cslammy/tubetrashexperimenterboard/README.md

# tubetrashexperimenterboard
1J24B board used to help design waveform modifiers, vcfs etc
see more information in this blog post: https://audiodiwhy.blogspot.com/2022/02/1j24b-part-ii-expermenters-board.html
