cslammy/tubetrashexperimenterboard/tube timbre trasher 1-9-22 notes.pdf

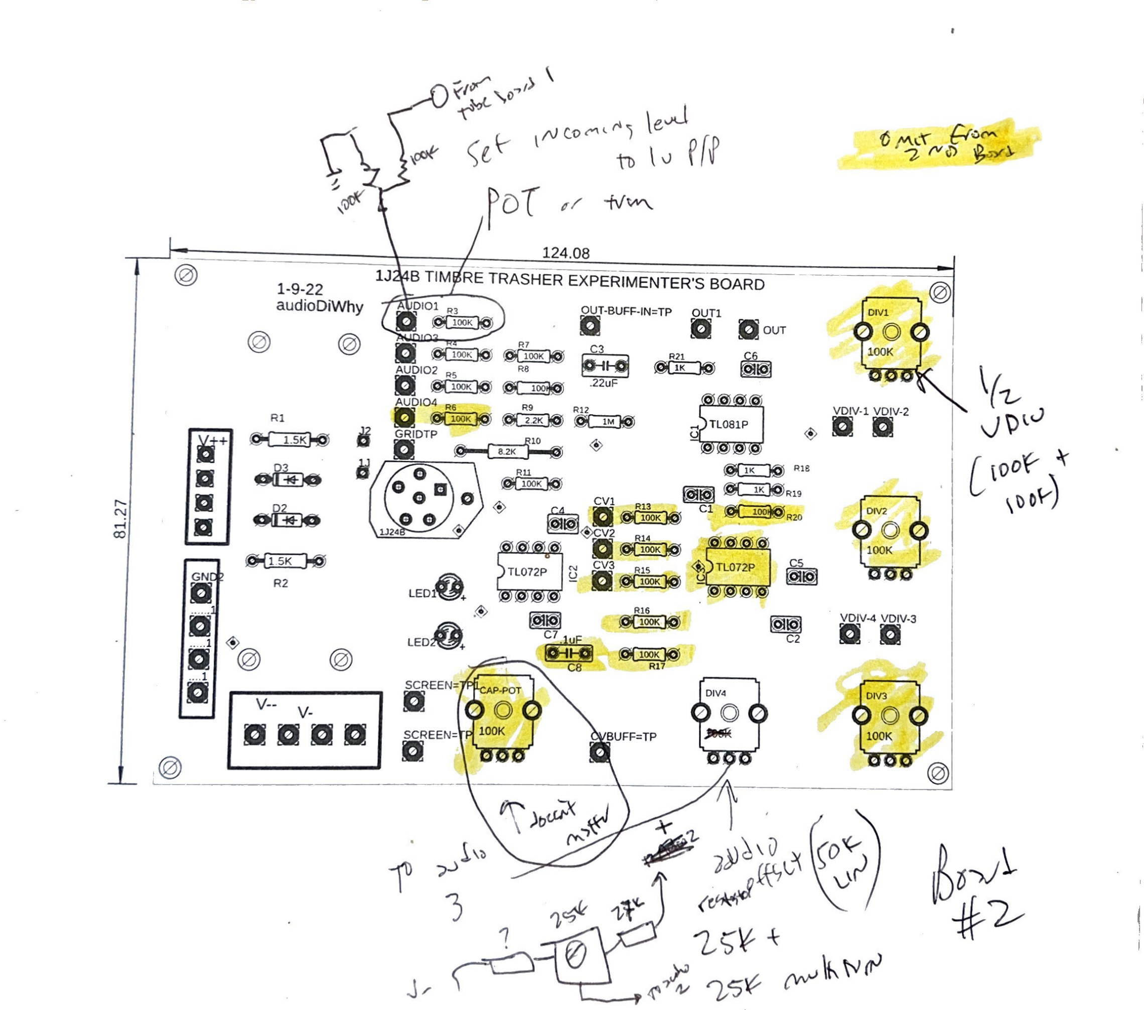
[picture p1: page 1]

ov | Evo | ®
ZOO Bor?

1-9-22
audioDiwhy | QUT-BUFF-INSTP | QUT1

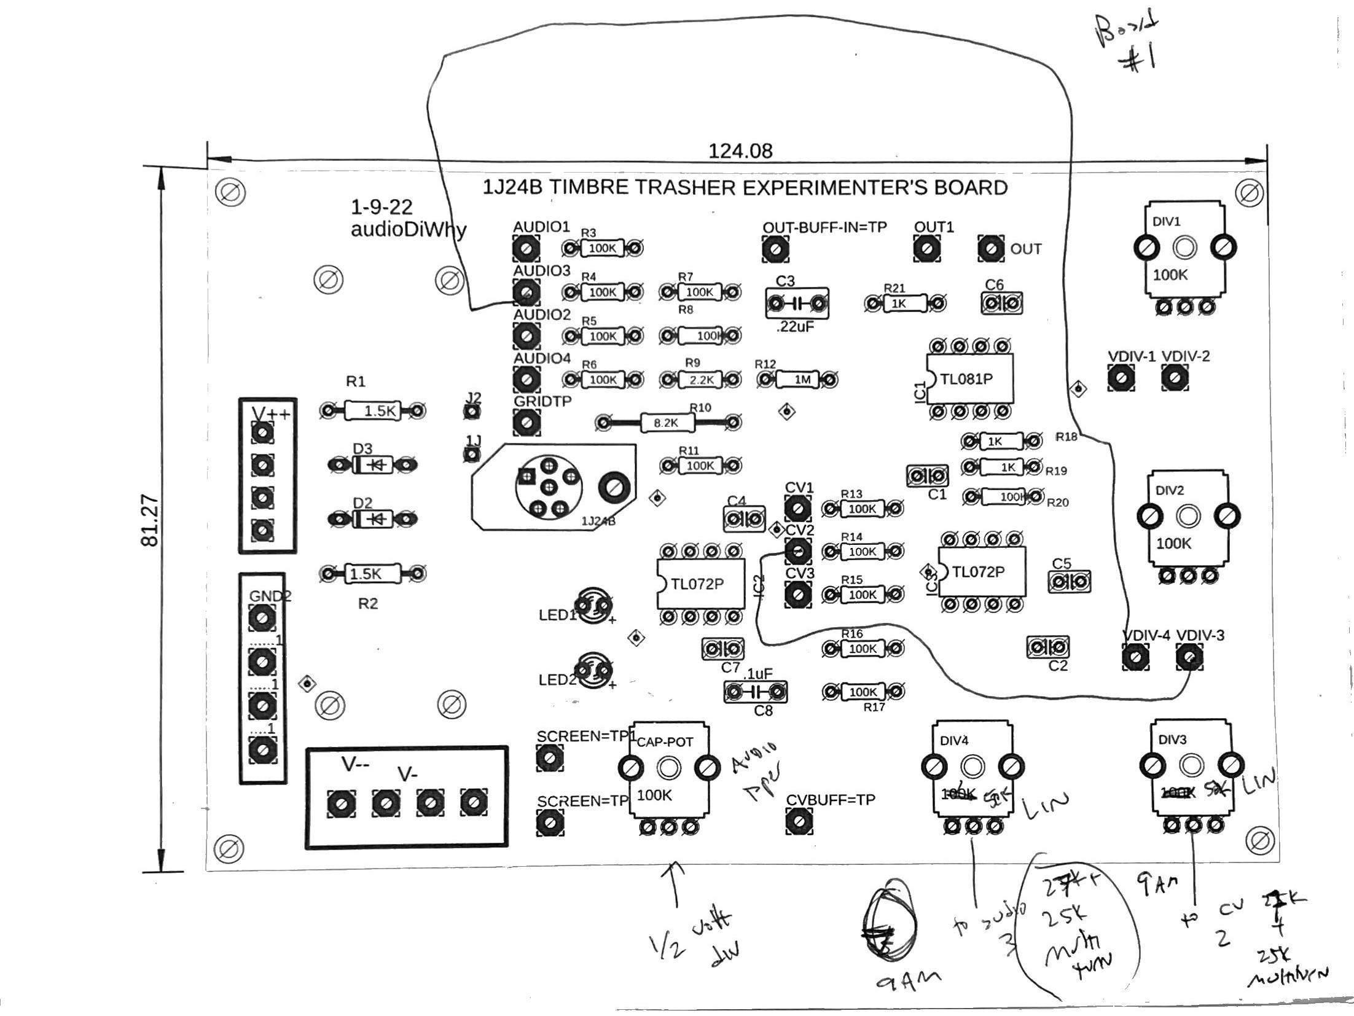
[picture p2: page 2]

~ 1924BTIMBRE TRASHER EXPERIMENTER'S BOARD _

audioDiwhy | AUDIOL ps | QUT-BUFF-IN=TP | OUT

124.08

Lic} | Oo | QO | Qo

a

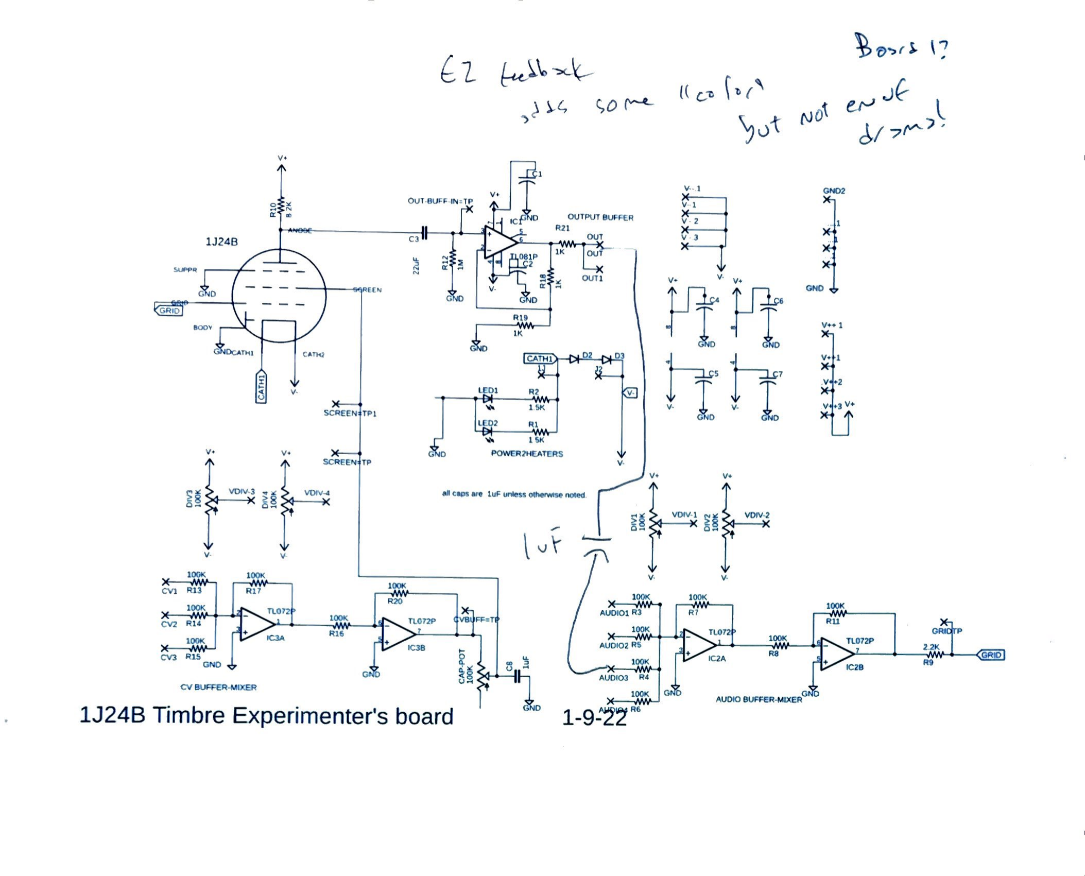
[picture p3: page 3]

B
é

1J24B Timbre Experimenter's board

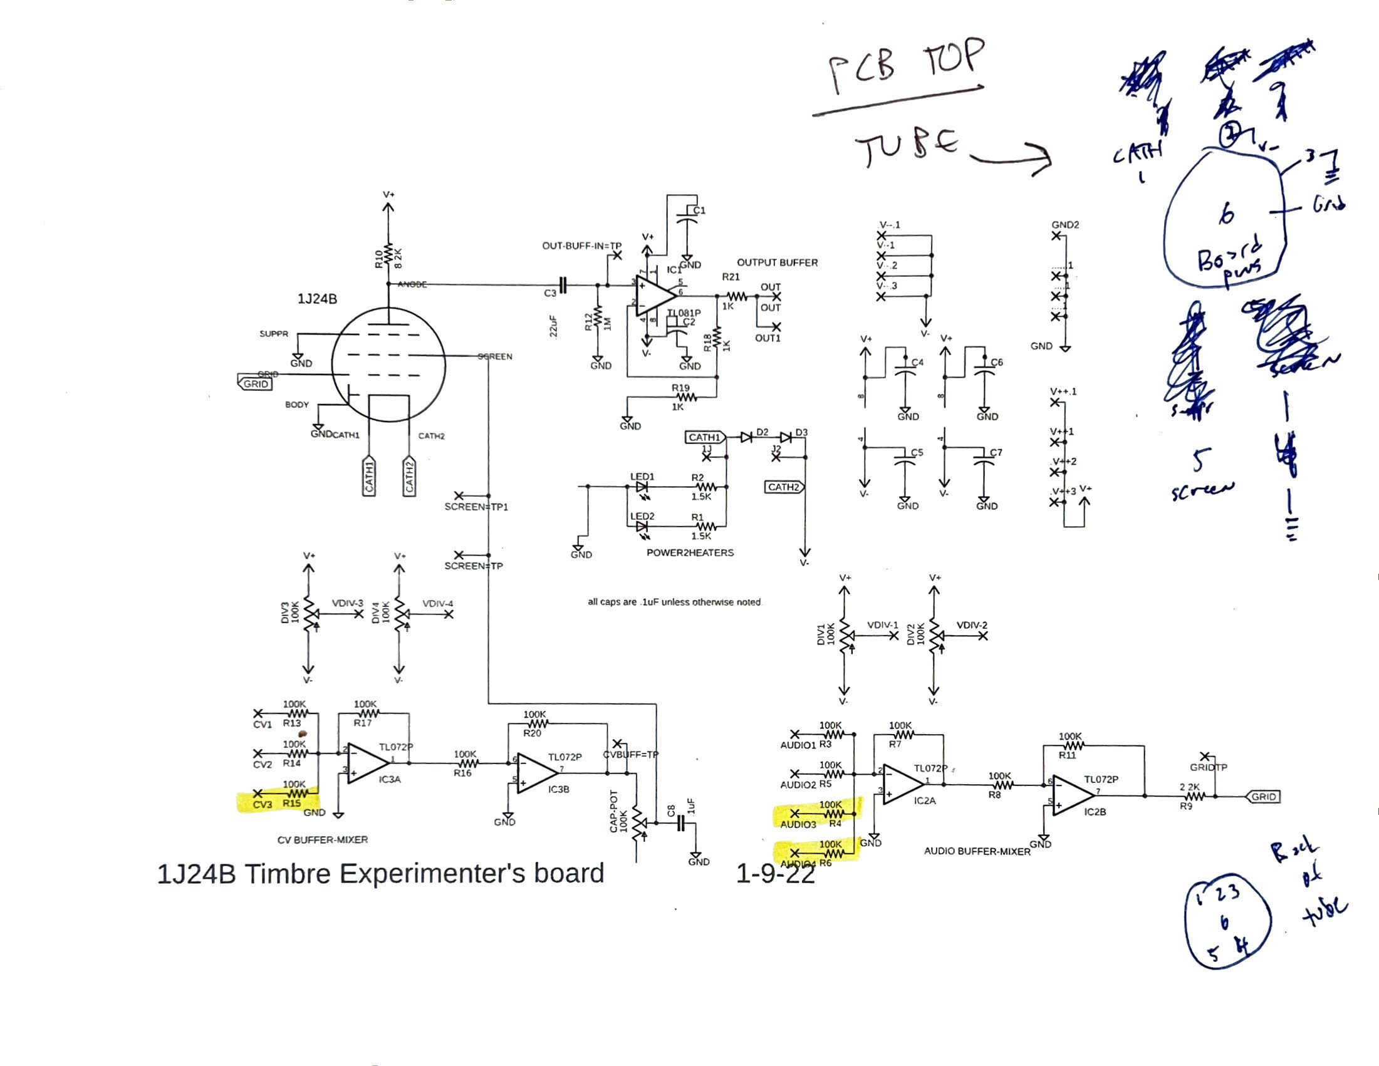
[picture p4: page 4]

all capsare .luFunless otherwise noled

iD
1J24B Timbre Experimenter's board
