cslammy/tubetrashexperimenterboard/tubetimbertrasher pcb and schem.pdf

3

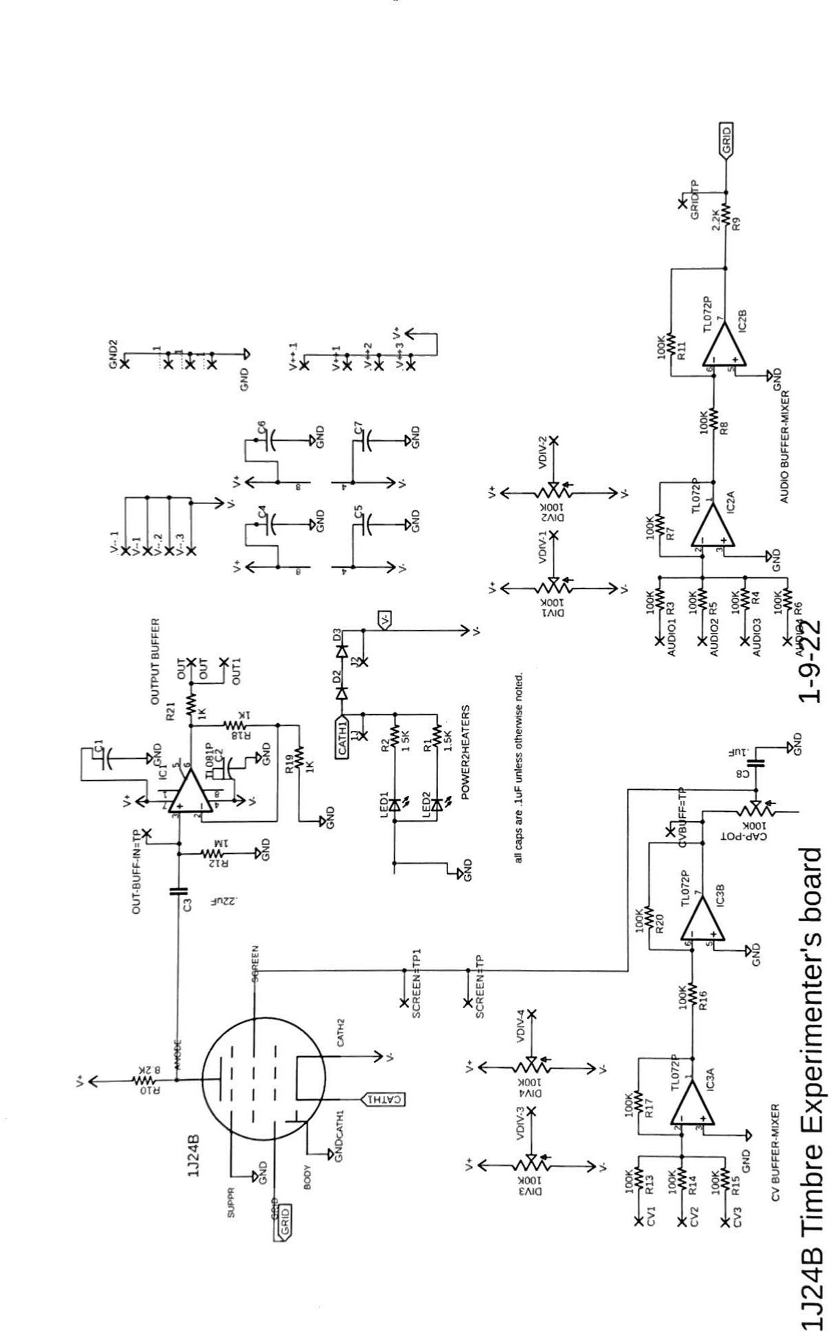
[picture p5: page 1]

"paiou aswmuaipo ssapun nT" are sete ye

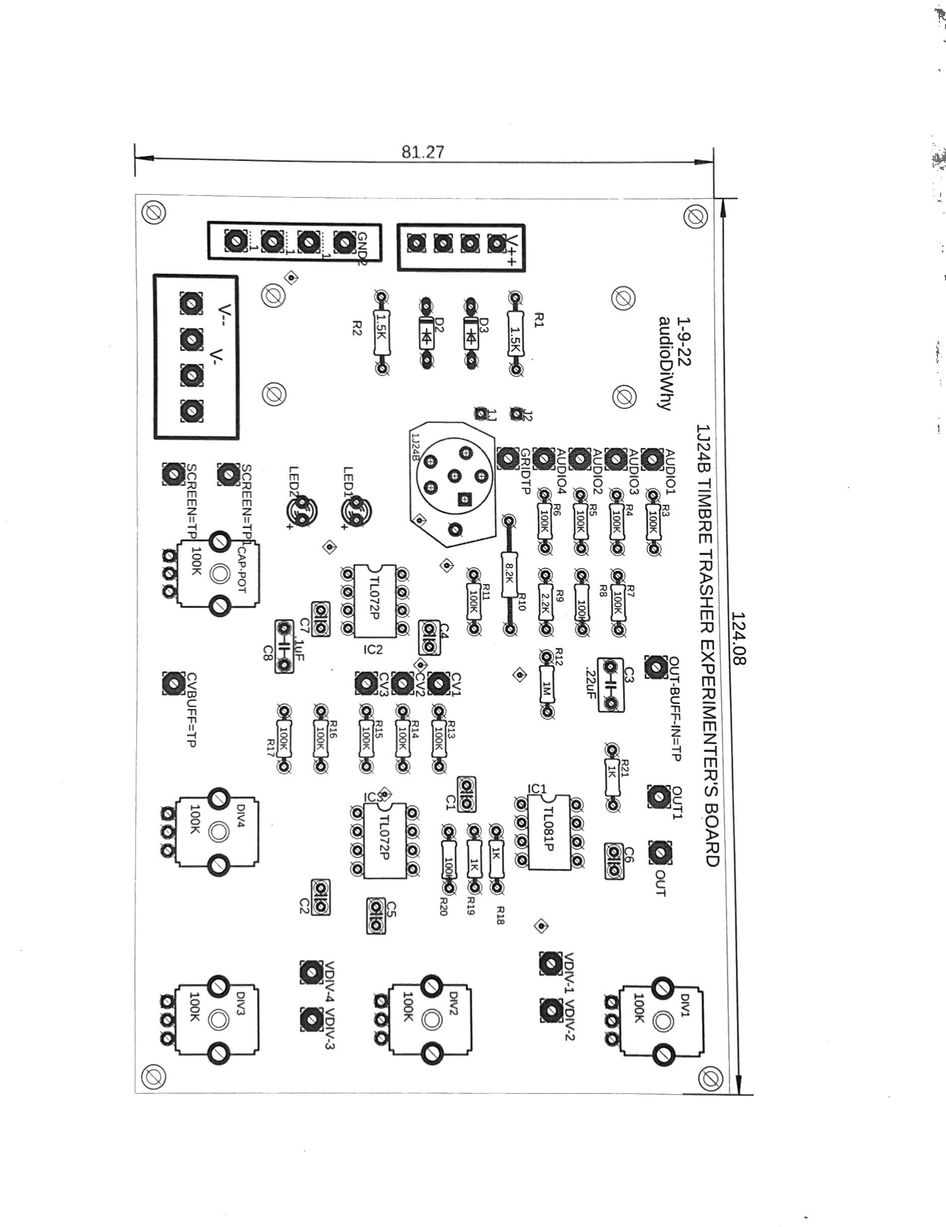
[picture p6: page 2]

©

1.9.29 1J24B TIMBRE TRASHR EXPERIMENTER'S BOARD

audioDiwhy QUT-BUFFAN=TP

=

# OUT]

# SoGOBu

©

# AUDIO2 ps

car

## OspeAUDIO4

CVBUFF=TP
