cslammy/tubetrashexperimenterboard/board.PNG

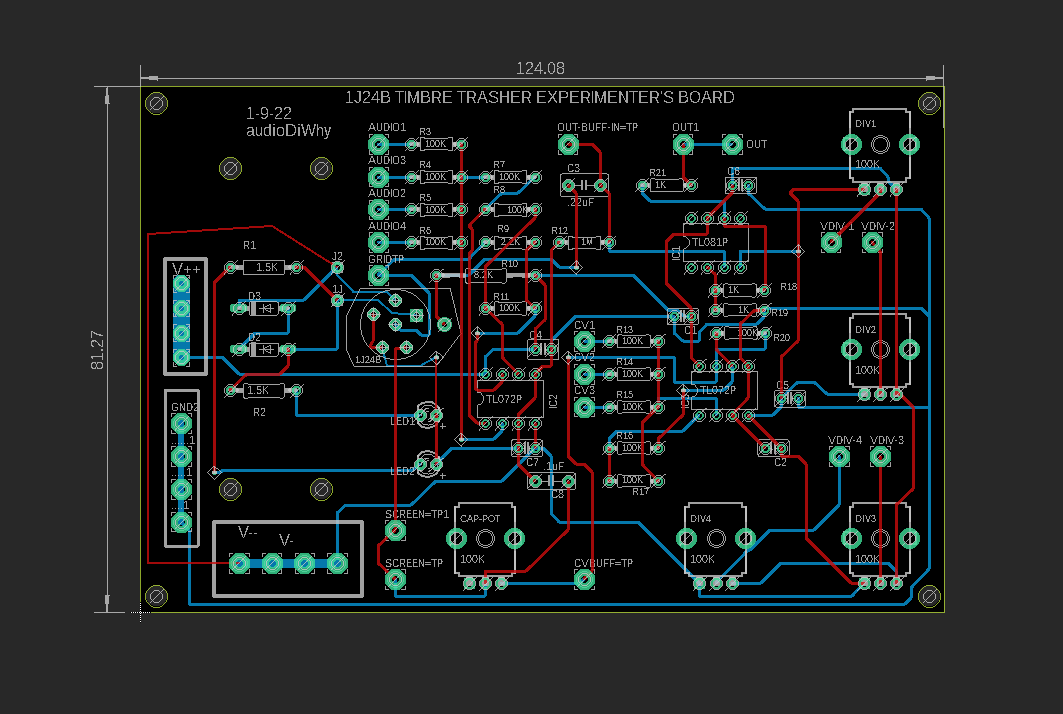
board.PNG
