cslammy/tubetrashexperimenterboard/tube timbre trasher 1-9-22-fix.brd

## EAGLE design tube timbre trasher 1-9-22-fix.brd (2022-02-13)

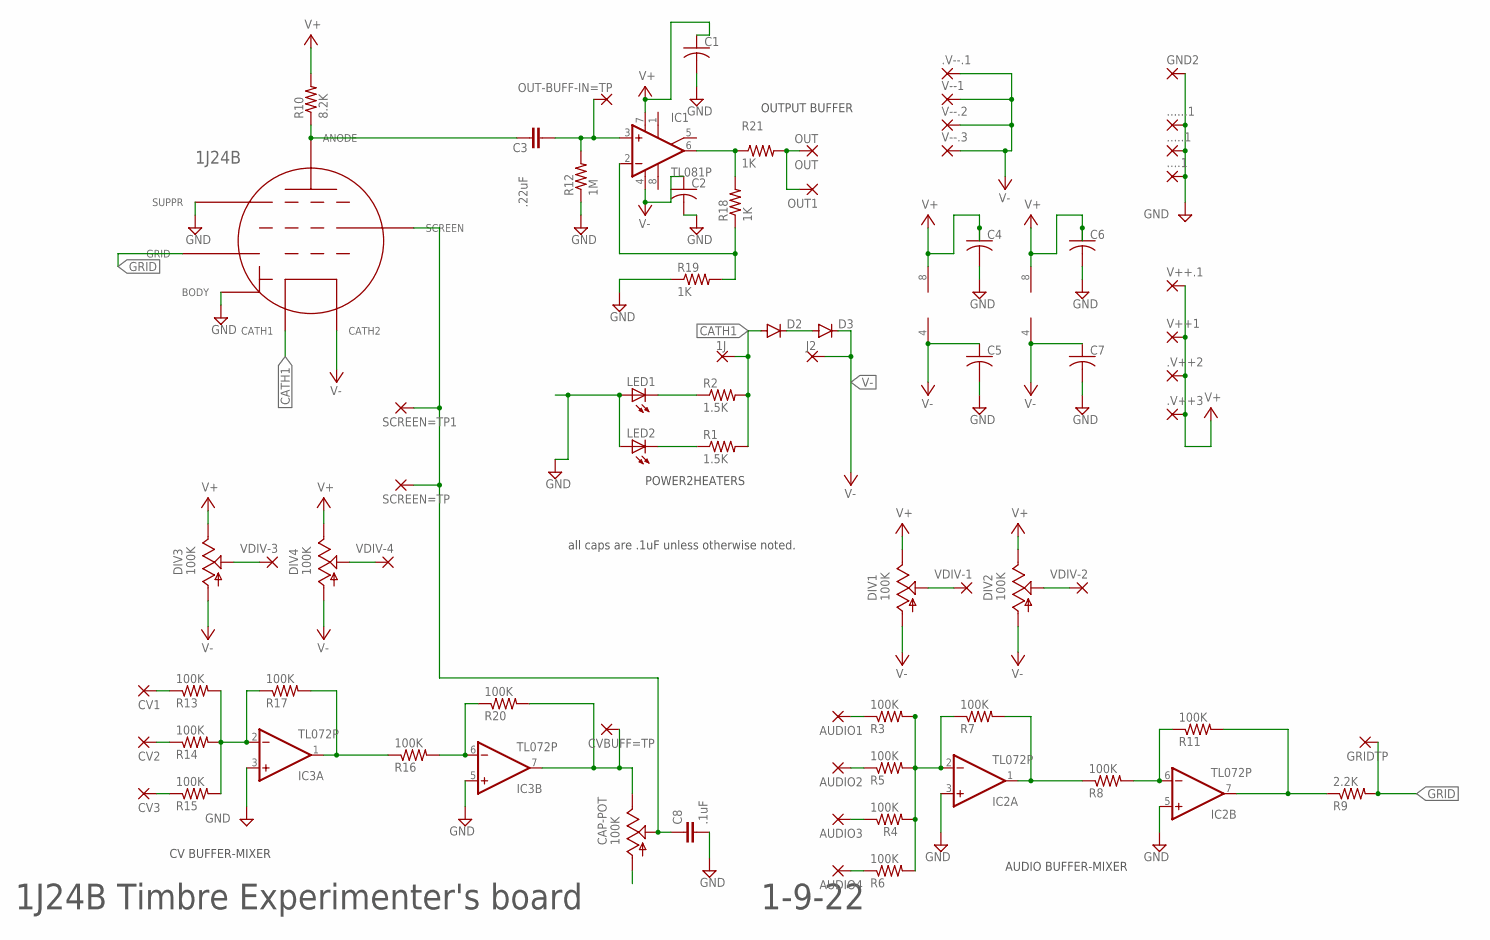
[picture p8: schematic tube timbre trasher 1-9-22-fix.sch]

Parts:
1J: 1; 1,6/0,9
1J24B: 1J24B; 6PINSOLDER
....1, .....1, ......1, .V--.1: 3,17/1,3
.V++2, .V++3: 2,54/1,0
AUDIO1, AUDIO2, AUDIO3, AUDIO4: 3,17/1,3
C1, C2, C5, C6, C7: C-US025-025X050; C025-025X050
C3: .22uF; C5B3.5
C4: C-US025-030X050; C025-030X050
C8: .1uF; C5B2.5
CAP-POT: 100K; 9MM_SNAP-IN_POT
CV1, CV2, CV3: 3,17/1,3
CVBUFF=TP: 3,17/1,3
D2, D3: 1N4148DO35-7; DO35-7
DIV1, DIV2, DIV3, DIV4: 100K; 9MM_SNAP-IN_POT
GND2: 3,17/1,3
GRIDTP: 3,17/1,3
IC1: TL081P; DIL08
IC2, IC3: TL072P; DIL08
J2: 1; 1,6/0,9
LED1, LED2: LED3MM
OUT: OUT; 3,17/1,3
OUT1: 3,17/1,3
OUT-BUFF-IN=TP: 3,17/1,3
R1, R2: 1.5K; 0207/10
R3, R4, R5, R6, R7, R8, R11, R13, R14, R15, R16, R17, R20: 100K; 0204/7
R9: 2.2K; 0204/7
R10: 8.2K; 0207/15
R12: 1M; 0204/7
R18, R19, R21: 1K; 0204/7
SCREEN=TP, SCREEN=TP1: 3,17/1,3
V++1, V++.1: 2,54/1,0
V--1, V--.2, V--.3: 3,17/1,3
VDIV-1, VDIV-2, VDIV-3, VDIV-4: 3,17/1,3

Connections:
CATH1: 1J.1, 1J24B.1-CATH (CATH1), D2.A, R1.2, R2.2
GND: 1J24B.3-BDY (BODY), 1J24B.4-SUPP (SUPPR), ....1.1, .....1.1, ......1.1, C1.2, C2.2, C4.2, C5.2, C6.2, C7.2, C8.2, GND2.1, IC2.3 (+IN), IC2.5 (+IN), IC3.3 (+IN), IC3.5 (+IN), LED1.A, LED2.A, R12.1, R19.1
GRID: 1J24B.6-GRID (GRID), GRIDTP.1, R9.2
unnamed: 1J24B.A (ANODE), C3.1, R10.1
unnamed: C3.2, IC1.3 (+IN), OUT-BUFF-IN=TP.1, R12.2
unnamed: LED2.K (C), R1.1
unnamed: IC1.6 (OUT), R18.2, R21.1
unnamed: LED1.K (C), R2.1
unnamed: AUDIO1.1, R3.1
unnamed: DIV1.2 (S), VDIV-1.1
unnamed: DIV2.2 (S), VDIV-2.1
unnamed: D2.C, D3.A
unnamed: AUDIO3.1, R4.1
unnamed: IC2.6 (-IN), R8.2, R11.1
unnamed: IC3.6 (-IN), R16.2, R20.1
unnamed: IC2.7 (OUT), R9.1, R11.2
unnamed: AUDIO2.1, R5.1
unnamed: IC2.2 (-IN), R3.2, R4.2, R5.2, R6.2, R7.1
unnamed: IC2.1 (OUT), R7.2, R8.1
unnamed: CAP-POT.3 (E), CVBUFF=TP.1, IC3.7 (OUT), R20.2
unnamed: IC1.2 (-IN), R18.1, R19.2
unnamed: OUT.1, OUT1.1, R21.2
unnamed: CV2.1, R14.1
unnamed: IC3.2 (-IN), R13.2, R14.2, R15.2, R17.1
unnamed: IC3.1 (OUT), R16.1, R17.2
unnamed: CV1.1, R13.1
unnamed: DIV3.2 (S), VDIV-3.1
unnamed: DIV4.2 (S), VDIV-4.1
unnamed: CV3.1, R15.1
unnamed: AUDIO4.1, R6.1
TIE: 1J24B.5-SCR (SCREEN), C8.1, CAP-POT.2 (S), SCREEN=TP.1, SCREEN=TP1.1
V+: .V++2.1, .V++3.1, C1.1, C4.1, C6.1, DIV1.3 (E), DIV2.3 (E), DIV3.3 (E), DIV4.3 (E), IC1.7 (V+), IC2.8 (V+), IC3.8 (V+), R10.2, V++1.1, V++.1.1
V-: 1J24B.2-CATH (CATH2), .V--.1.1, C2.1, C5.1, C7.1, D3.C, DIV1.1 (A), DIV2.1 (A), DIV3.1 (A), DIV4.1 (A), IC1.4 (V-), IC2.4 (V-), IC3.4 (V-), J2.1, V--1.1, V--.2.1, V--.3.1

Notes on the sheet:
POWER2HEATERS
1J24B Timbre Experimenter's board
1-9-22
CV BUFFER-MIXER
AUDIO BUFFER-MIXER
OUTPUT BUFFER
all caps are .1uF unless otherwise noted.

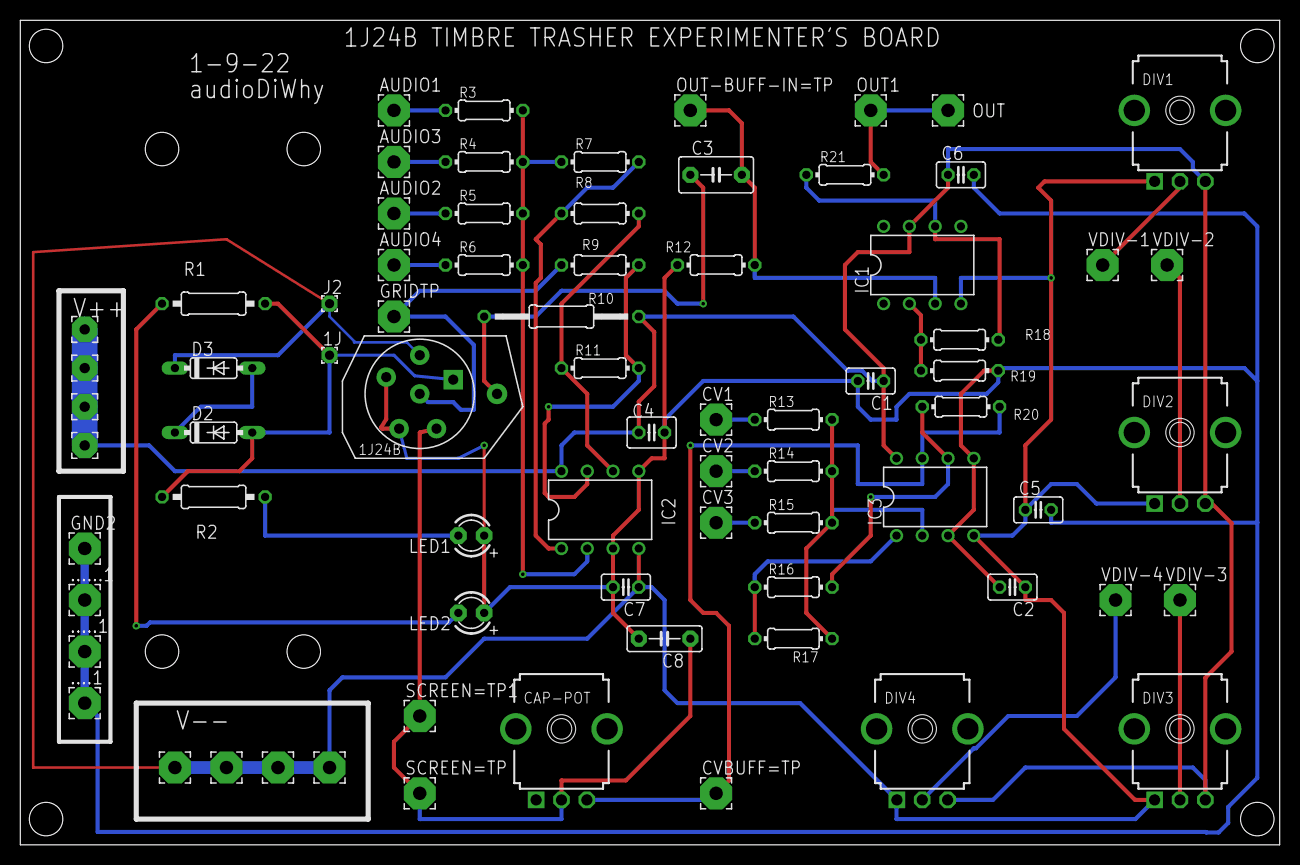
[picture p9: board tube timbre trasher 1-9-22-fix.brd from above]

Board: 2 copper layers, 124.1 x 81.3 mm, 74 parts (0 on the bottom side), 33 nets.
