cslammy/tubetrashexperimenterboard/tube timber trasher 1-9-22 wiring.pdf

1J248

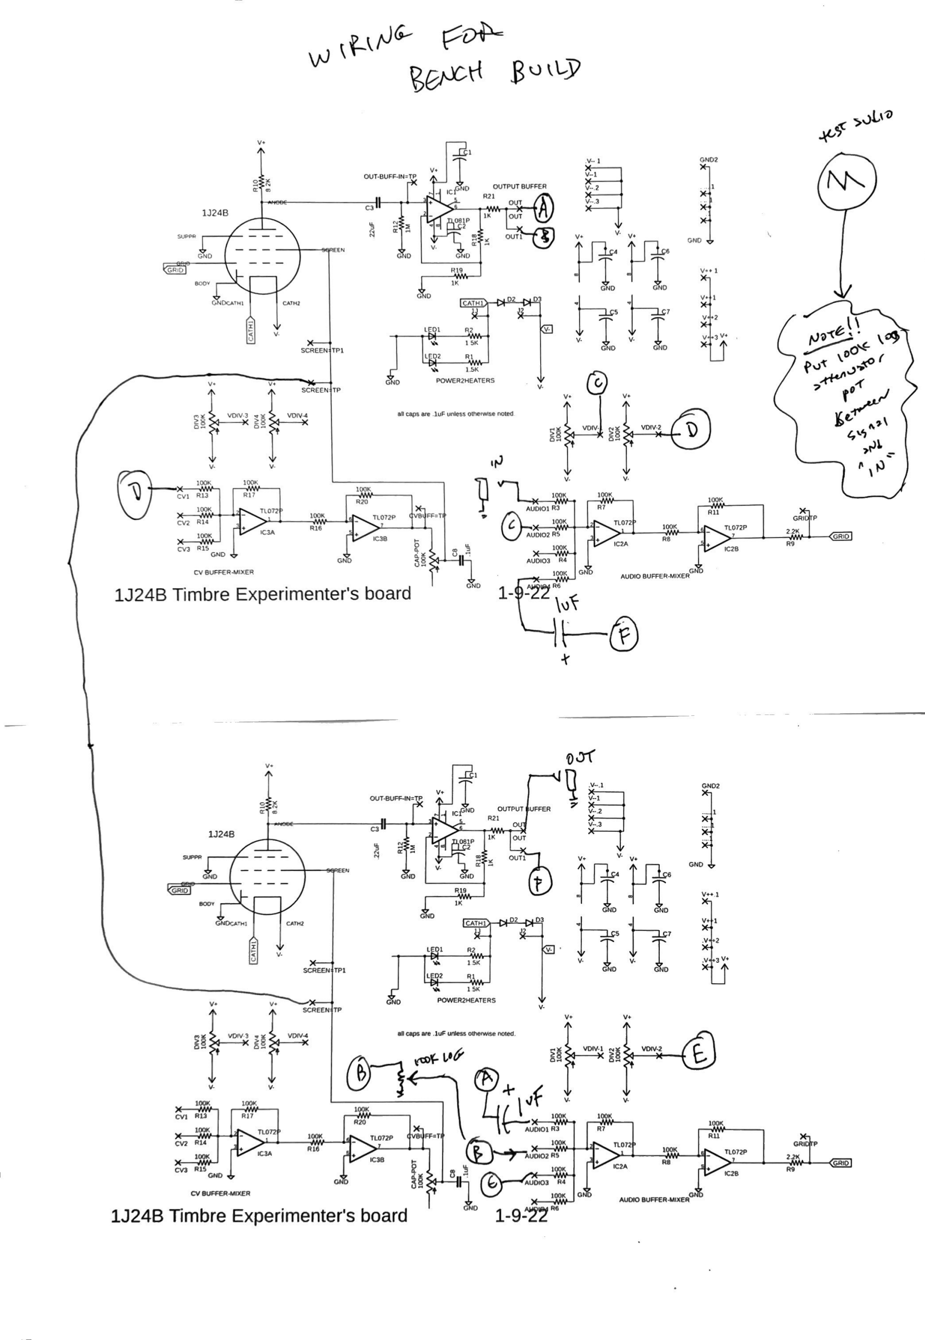
[picture p10: page 1]

SCREENFTPL

ve | Ve
SCREENTTP
VV. | = | VON
i | : | 7
v | Ds

3

100k | | 190
cv | R13 | x
100K, | | | | Re
cv2 Ria | i | > | 199 | P | Tiere | GVBUEFS" Ri6
KA 100K | ea

cya RIS
GND

CV BUFFER-AEXER

# 1J24B Timbre Experimenter's board
